posystorage/stm32-tiny/v1.5/预览背.JPG

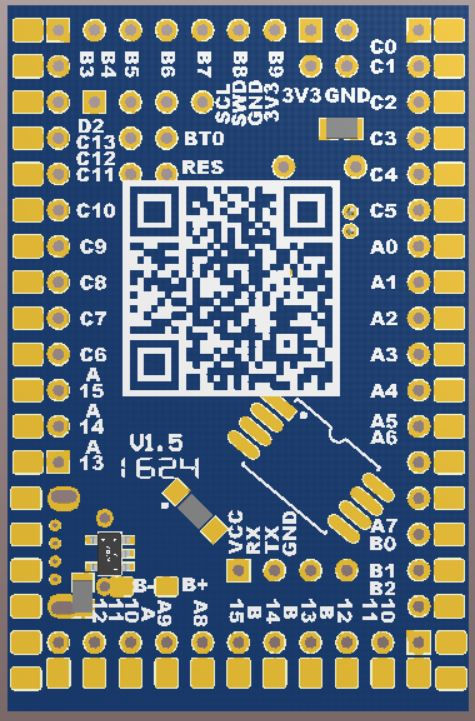
v1.5/预览背.JPG
