posystorage/stm32-tiny/v1.5/预览正.JPG

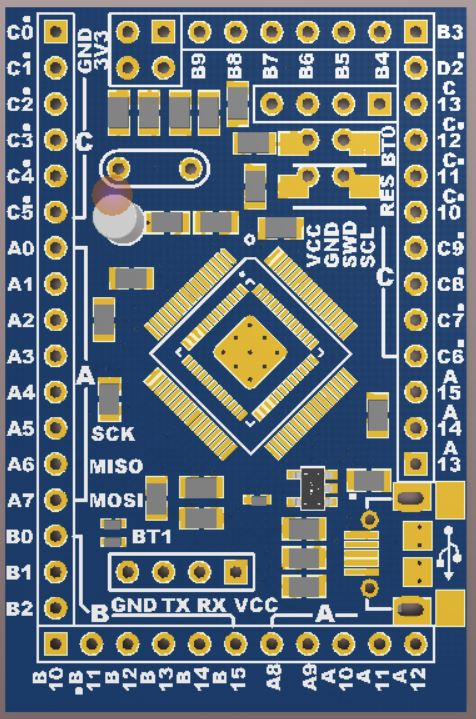
v1.5/预览正.JPG
