posystorage/stm32-tiny/README.md

# stm32-tiny

https://stm32-posystorage.rhcloud.com

核心小板

最小系统，引出所有引脚
