posystorage/stm32-tiny/v1.5/sch1.5 1.4.PDF

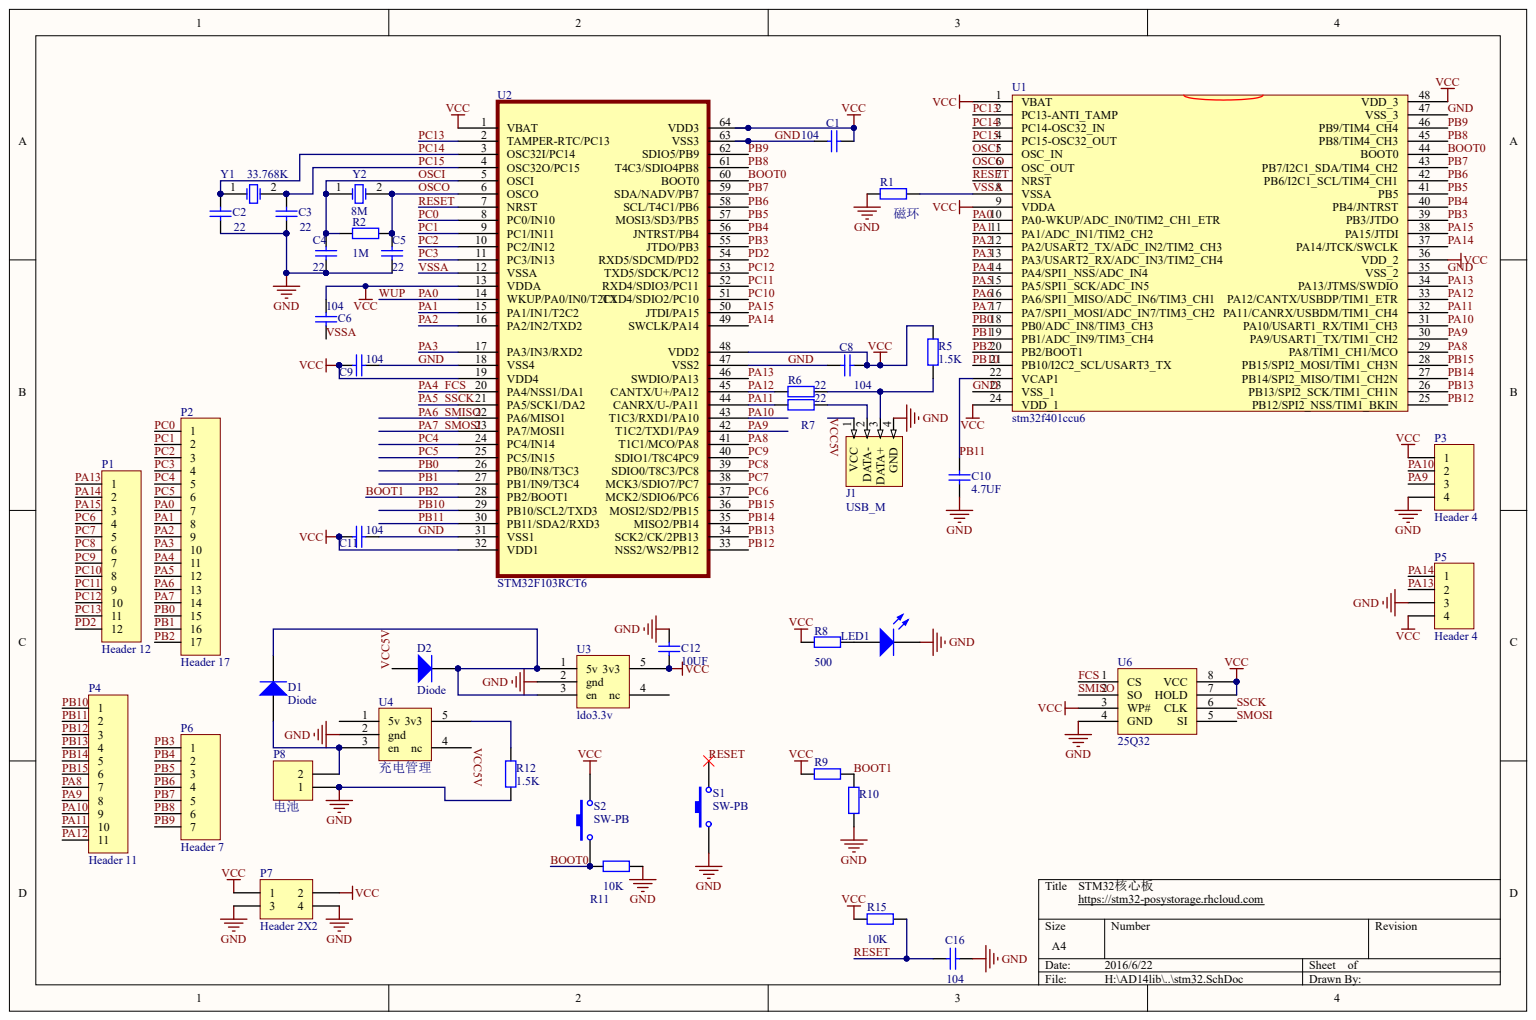
[picture p3: page 1]

STM32核心板
https://stm32-posystorage.rhcloud.com
