posystorage/stm32-tiny/v1.5/PCB1.5.PDF

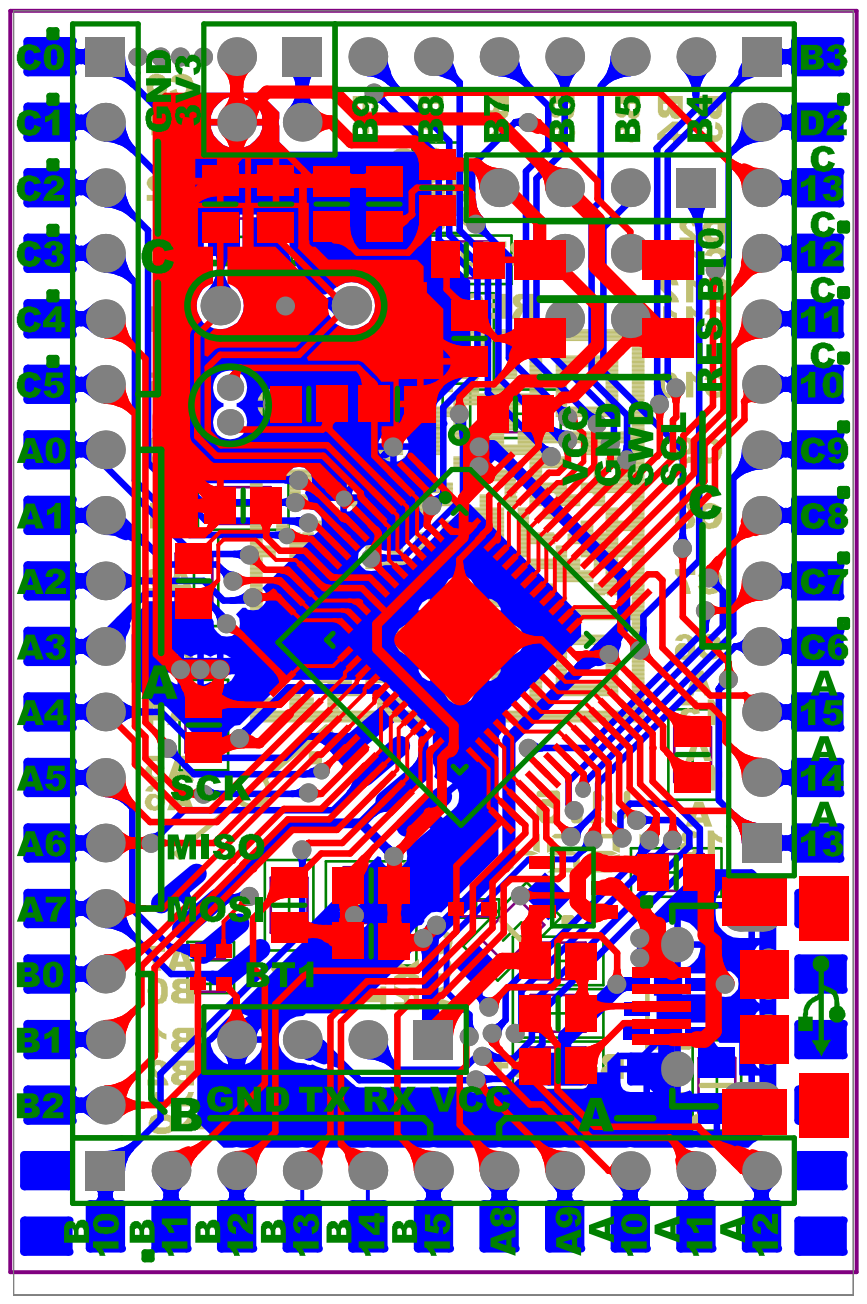
[picture p4: page 1]
