posystorage/stm32-tiny/(list of files, drawings)

Other design files:
v1.1/PCB1.PcbDoc
v1.1/stm32.SchDoc
v1.3/PCB1.PcbDoc
v1.3/stm32.SchDoc
v1.4/PCB1.PcbDoc
v1.4/stm32.SchDoc
v1.5/PCB1.PcbDoc
v1.5/充电.PcbDoc
