posystorage/stm32-tiny/(commit log)

2016-06-08 上传资料
    [PCB1.PcbDoc, stm32.SchDoc, 元件焊接提示BOM1.2.xlsx, 元件焊接提示BOM1.3.xlsx]
2016-06-15 上传实物图
    [元件焊接提示BOM1.1.xlsx]
2016-06-15 修改readme
2016-06-22 1.5资料
    [元件焊接提示BOM1.1.xlsx, 元件焊接提示BOM1.3.xlsx, 元件焊接提示BOM1.3发布.xlsx, 元件焊接提示BOM1.4.xlsx, 元件焊接提示BOM1.4发布.xlsx, 元件焊接提示BOM1.5发布.xlsx, 充电.PcbDoc]
